AlksSAV/RC-Boat-Speed-Log/3D Model/Log tube.stl

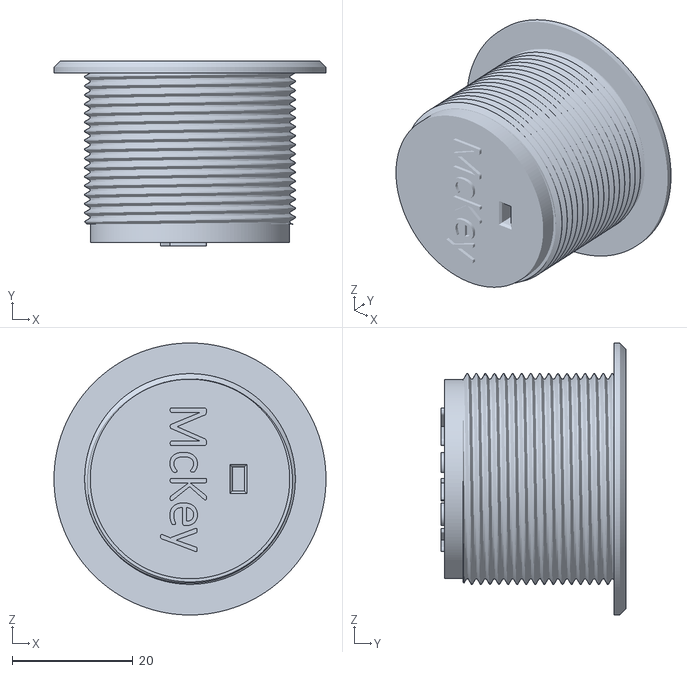
[picture p3: CAD file, 2023-12-13]
3D Model/Log tube.stl
45.0 x 30.6 x 45.0
