AlksSAV/RC-Boat-Speed-Log/3D Model/Ring.stl

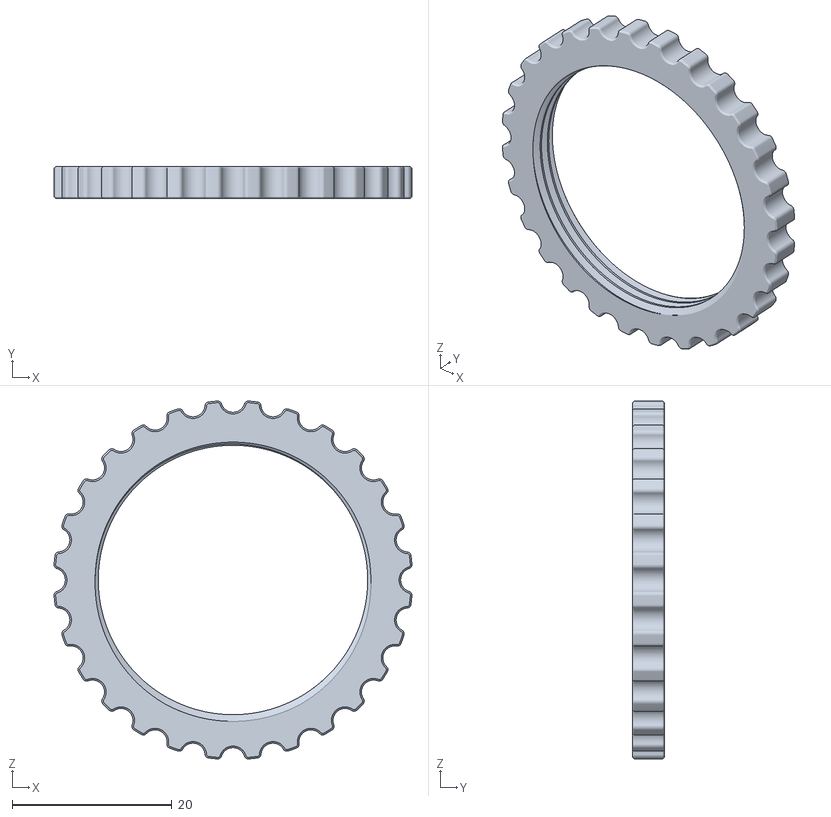
[picture p4: CAD file, 2023-11-26]
3D Model/Ring.stl
44.8 x 4.00 x 44.8
