AlksSAV/RC-Boat-Speed-Log/3D Model/Test model/impeller v2.stl

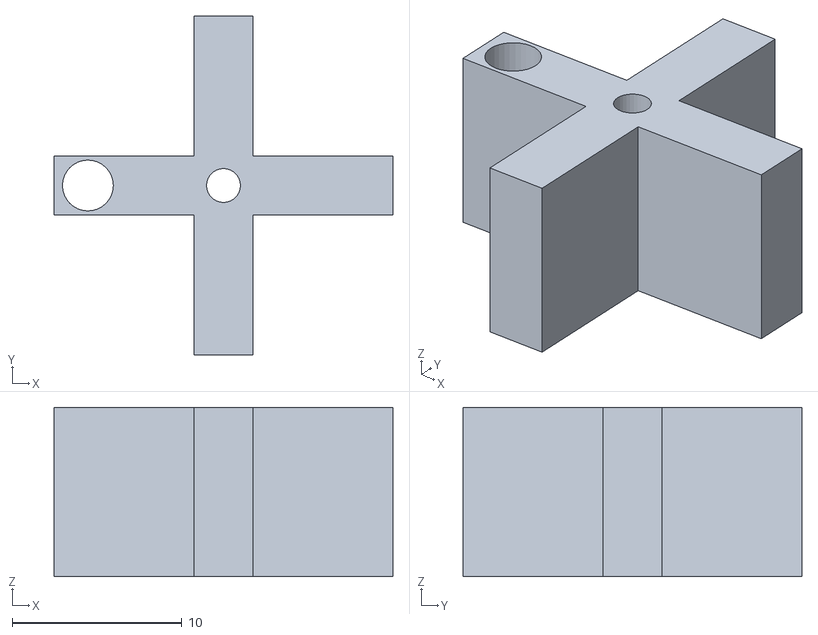
[picture p5: CAD file, 2023-11-19]
3D Model/Test model/impeller v2.stl
20.0 x 20.0 x 10.0
