AlksSAV/RC-Boat-Speed-Log/3D Model/Lock.stl

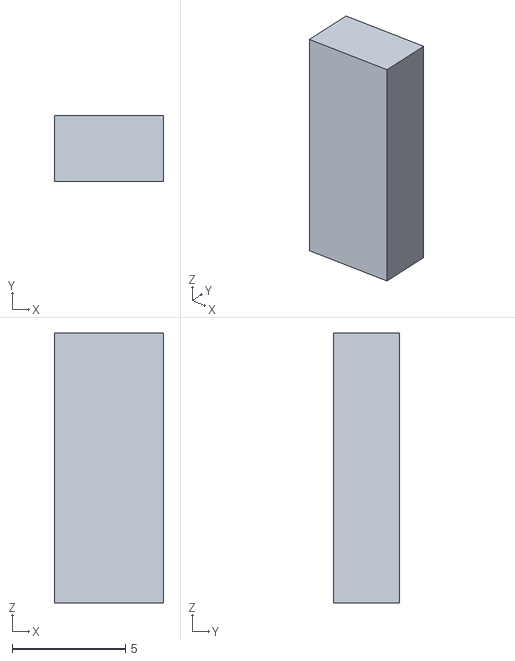
[picture p6: CAD file, 2023-11-26]
3D Model/Lock.stl
4.80 x 2.90 x 11.9
