AlksSAV/RC-Boat-Speed-Log/3D Model/Test model/body.stl

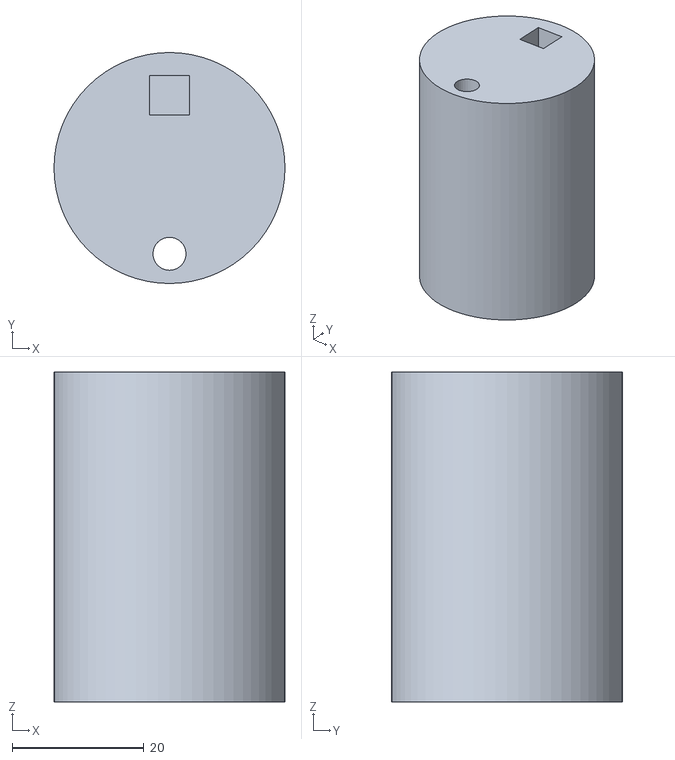
[picture p7: CAD file, 2023-11-19]
3D Model/Test model/body.stl
35.0 x 35.0 x 50.0
