AlksSAV/RC-Boat-Speed-Log/3D Model/Rotor.stl

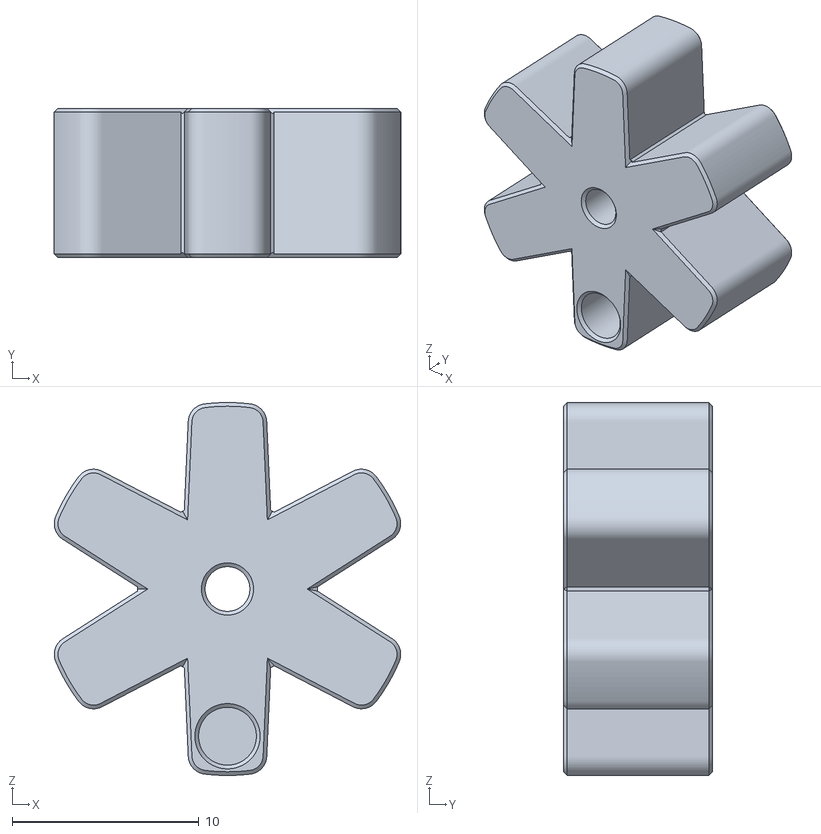
[picture p8: CAD file, 2023-11-26]
3D Model/Rotor.stl
18.6 x 8.00 x 20.0
