AlksSAV/RC-Boat-Speed-Log/3D Model/Test model/impeller v1.stl

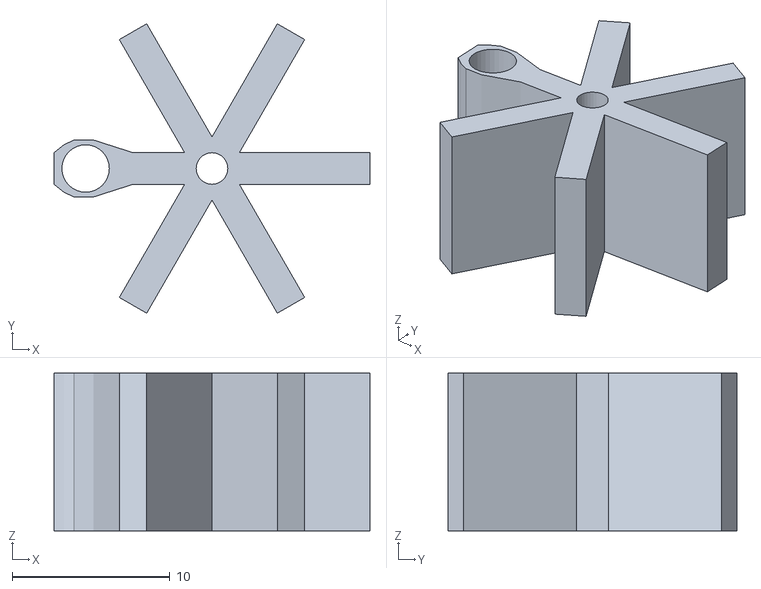
[picture p9: CAD file, 2023-11-19, an earlier design]
3D Model/Test model/impeller v1.stl
20.0 x 18.3 x 10.0
