AlksSAV/RC-Boat-Speed-Log/(list of files, cad)

Other CAD files:
3D Model/v 2/WaterSpeedLog.f3d
