AlksSAV/RC-Boat-Speed-Log/(commit log)

2023-05-22 TCA9548A
    TCA9548A Low-Voltage 8-Channel I2C
2023-11-17 Add datasheet
    Hall sensor
2023-11-17 Circuit diagramm
    electronic
2023-11-17 sketch file
    arduino file
2023-11-19 3d model
    STL files
    [body.stl, impeller v1.stl, impeller v2.stl]
2023-11-26 STL file
    file to print
    [Lock.stl, Ring.stl, Rotor.stl, Tube holeless.stl, Tube.stl]
2023-12-13 Test model
    [body.stl, impeller v1.stl, impeller v2.stl]
2023-12-13 New model
    optimal model
    [Log tube.stl]
2024-01-13 Update boatspeed.ino
    update coefficient (paddle r=10mm)
2024-01-24 V 2.0
    [WaterSpeedLog.f3d]
